brandon-lee18x/NutriScanner/LINKS.md

Below are the relevant links

- Final video presentation: https://drive.google.com/file/d/1XI3ovUptqXAfiE3kk2J0tyXWsabo5QL3/view?usp=sharing
- Final video presentation (Youtube link in case Google Drive doesn't load): https://youtu.be/aBR6sccpc8s
- Video demo: https://drive.google.com/file/d/1DQN7cmR9VCl5V5oqpZvRccD75Ug6m561/view
- Final report: https://docs.google.com/document/d/1IS763GmCJTpxgcAjg6Nw-JuNLq0iLYLeyr_QNlRHlyw/edit
