brandon-lee18x/NutriScanner/LoadCellBase.stl

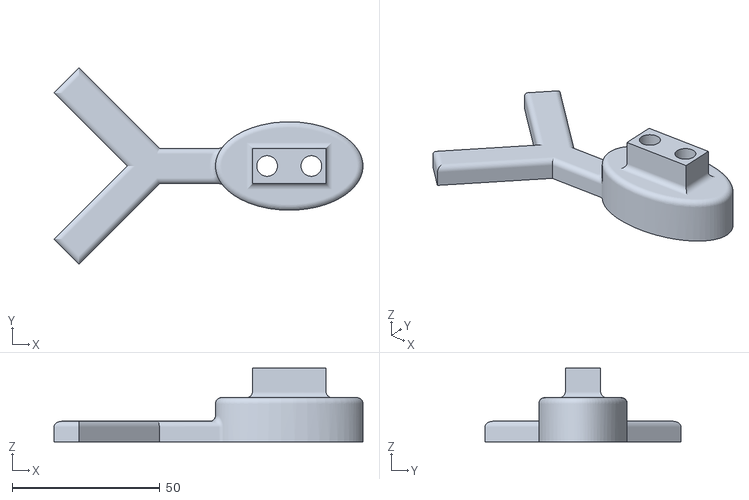
[picture p6: CAD file, 2024-02-16]
LoadCellBase.stl
104.7 x 66.5 x 25.0
