brandon-lee18x/NutriScanner/TopPlate (1).stl

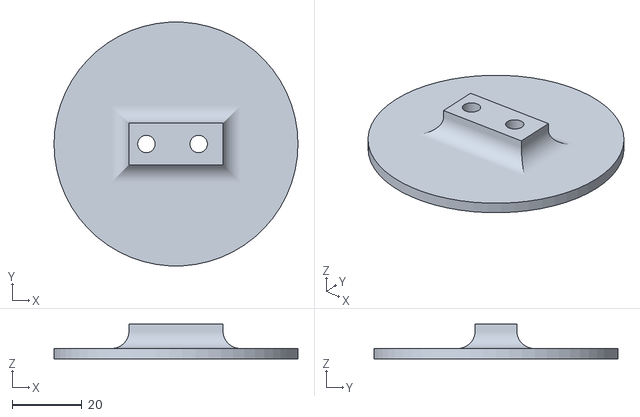
[picture p7: CAD file, 2024-02-16]
TopPlate (1).stl
70.0 x 69.9 x 10.0
